jjuneau1/MiniFAST/README.md

# MiniFAST
MiniFAST: Fast and Sensitive Miniaturized microscope for neural recording - compatible with Miniscope.org
