jjuneau1/MiniFAST/MiniFAST PCB/BOM/MiniPCBR3-for-assembly.xls

This is a sample BOM for Sierra Circuits' online BOM pricing system. Please use this preferred format for your BOM that you upload.
Note: DNI applies to whole row. If only some specific locations of a given ITEM are not to be installed, please create two rows for that item and mark one as DNI.
BOM: <MiniPCB>
R3
Jill Juneau/Rice University
Item # | Quantity per board | Manufacturer Part # | Do Not Install | Reference designators | Vendor (optional) | Vendor Part Number (optional) | Value (optional) | Size / Footprint (optional) | Part description/ specs (optional, but recommended) | Manfacturer (optional)
1 | 9 | C1005X8R1E103M050BA |  | C5, C21, C23, C25, C28, C31, C52, C53, C58 | Digi-Key | 445-13941-1-ND | 0.01uF | C0402 | CAP CER 10000PF 25V X7R 0402 | TDK
2 | 1 | GCM155R71E473KA55D |  | C34 | Digi-Key | 490-4760-1-ND | 0.047uF | C0402 | CAP CER 0.047UF 25V X7R 0402 | Murata
3 | 20 | GMK105BJ104KV-F |  | C2, C20, C22, C24, C27, C30, C33, C36, C38, C47, C48, C49, C50, C51, C54, C55, C56, C57, C60, C62 | Digi-Key | 587-1994-1-ND | 0.1uF | C0402 | CAP CER 0.1UF 35V X5R 0402 | TDK
4 | 1 | GRM155C8YA224ME01D |  | C4 | Digi-Key | 490-10446-1-ND | 0.22uF | C0402 | CAP CER 0.22UF 35V X6S 0402 | TDK
5 | 10 | CGB2A1X5R1E105M033BC |  | C1, C3, C11, C13, C14, C19, C35, C44, C45, C46 | Digi-Key | 445-13186-1-ND | 1uF | C0402 | MLCC, SOFT TERMINATION, 0402, X5, 35V | TDK
6 | 8 | GRM153R60J475ME15D |  | C15, C16, C17, C18, C37, C39, C41, C42 | Digi-Key | 490-13232-2-ND | 4.7uF | C0402 | CAP CER 4.7UF 6.3V X5R 0402 | Murata
7 | 2 | C1608JB1E475M080AC |  | C59, C61 | Digi-Key | 445-11254-1-ND | 4.7uF | C0603 | CAP CER 4.7UF 25V JB 0603 | TDK
8 | 8 | GRM155R60J106ME47D |  | C6, C7, C8, C9, C10, C12, C26, C29 | Digi-Key | 490-13239-1-ND | 10uF | C0402 | CAP CER 10UF 6.3V X5R 0402 | Murata
9 | 1 | GRM155R60J156ME05D |  | C32 | Mouser | 490-18659-1-ND | 15uF | C0402 | CAP CER 15UF 6.3V X5R 0402 | TDK
10 | 1 | LTST-C191KRKT |  | D1 | Digi-Key | 160-1447-1-ND |  | D0603 | LED
11 | 2 | MMZ1005Y102CT000 |  | L1, L2 | Digi-Key | 445-2157-1-ND |  | L0402 | FERRITE BEAD 1 KOHM 0402 1LN | TDK
12 | 1 | BRC2012T4R7MD |  | L3 | Digi-Key/ Customer Provided | 587-2907-1-ND |  | 2012 | FIXED IND 4.7UH 600MA 344.5 MOHM | Samsung Electro-Mechanics
13 | 1 | LPS4018-104MRC |  | L4 | Mouser | 994-LPS4018-104MRC | 100uH | LPS4018 | Fixed Inductors LPS4018 Low Profile 100uH 0.5A 20% SMD | Coilcraft
14 | 1 | BLM18KG601SN1D |  | L5 | Digi-Key | 490-5258-1-ND |  | L0603 | 600 OHM 0603 1LN | Murata
15 | 1 | ERJ-2RKF10R0X |  | R12 | Digi-Key | P10.0LCT-ND | 10 | R0402 | Resistor | Panasonic
16 | 1 | ERJ-2RKF49R9X |  | R2 | Digi-Key | P49.9LTR-ND | 49.9 | R0402 | Resistor | Panasonic
17 | 6 | ERJ-2RKF4990X |  | R14, R15, R16, R17, R18, R19 | Digi-Key | P499LCT-ND | 499 | R0402 | RES SMD 499 OHM 1% 1/10W 0402 | Panasonic
18 | 4 | ERJ-2RKF1001X |  | R6, R7, R11, R13 | Digi-Key | P1.00KLCT-ND | 1k | R0402 | RES SMD 1K OHM 1% 1/10W 0402 | Panasonic
19 | 1 | ERJ-2RKF4021X |  | R10 | Digi-Key | P4.02KLCT-ND | 4.02K | R0402 | RES SMD 4.02K OHM 1% 1/10W 0402 | Panasonic
20 | 1 | ERJ-2RKF1002X |  | R4 | Digi-Key | P10.0KLCT-ND | 10k | R0402 | RES SMD 10K OHM 1% 1/10W 0402 | Panasonic
21 | 3 | ERJ-2RKF1003X |  | R1, R3, R5 | Digi-Key | P100KLCT-ND | 100k | R0402 | RES SMD 100K OHM 1% 1/10W 0402 | Panasonic
22 | 1 | ERJ-2GE0R00X |  | R9 | Digi-Key | P0.0JCT-ND | 0 | R0403 | RES SMD 0 OHM JUMPER 1/10W 0402 | Panasonic
23 | 1 | Do Not Populate |  | R8 |  |  | DNP
24 | 1 | IMX290LLR-C |  | U1 | Customer Provided |  |  | 110-LGA - Thin | Sony Image Sensor | Sony
25 | 1 | DSC1001DL2-074.2500 |  | U2 | Digi-Key | DSC1001DL2-074.2500-ND |  | CDFN | 74.25MHz Oscillator | Microchip
26 | 1 | DS90UB913ATRTVRQ1 |  | U3 | Digi-Key | 296-46295-1-ND |  | WQFN32 for DS90UB913A | DS90UR913ASERIALIZER | TI
27 | 1 | MAX14595ETA+T |  | U4 | Digi-Key | MAX14595ETA+TCT-ND |  | 8 TDFN | Level Translator | Maxim
28 | 1 | DAC5571IDBVR |  | U5 | Digi-Key | 296-38918-1-ND |  | TI-DBV6_M | Low-Power, 8-Bit DAC with High-Speed I2C Input, -40 to 105 degC, 6-pin SOT23 (DBV6), Green (RoHS & no Sb/Br) | TI
29 | 1 | LT3092EDD#TRPBF |  | U6 | Digi-Key | LT3092EDD#TRPBFCT-ND |  | LT-DD-8_V | 200 mA Two-Terminal Programmable Current Source, 0.3 mA Isupply, 8-pin SON (DD-8), -40 to 125 degC, Pb-Free | LT
30 | 1 | TLV71128512DSET |  | U7 | Digi-Key | 296-47460-2-ND |  | DSE | Dual 2.85V and 1.2V Linear Regulator | TI
31 | 1 | TPS72718DSER |  | U8 | Mouser | 595-TPS72718DSER |  | DSE | Single 1.8V Linear Regulator | TI
END OF BOM
