jjuneau1/MiniFAST/MiniFAST PCB/Project Outputs for MiniR3/MiniPCBR3.xlsx

Comment | Description | Designator | Footprint | LibRef | Quantity
1uF |  | C1, C3, C11, C13, C14, C19, C35, C44, C45, C46 | SMD CAP 0402 | Capacitor | 10
0.1uF |  | C2, C20, C22, C24, C27, C30, C33, C36, C38, C47, C48, C49, C50, C51, C54, C55, C56, C57, C60, C62 | SMD CAP 0402 | Capacitor | 20
0.22uF |  | C4 | SMD CAP 0402 | Capacitor | 1
0.01uF |  | C5, C21, C23, C25, C28, C31, C52, C53, C58 | SMD CAP 0402 | Capacitor | 9
10uF |  | C6, C7, C8, C9, C10, C12, C26, C29 | SMD CAP 0402 | Capacitor | 8
4.7uF |  | C15, C16, C17, C18, C37, C39, C41, C42 | SMD CAP 0402 | Capacitor | 8
15uF |  | C32 | SMD CAP 0402 | Capacitor | 1
0.047uF |  | C34 | SMD CAP 0402 | Capacitor | 1
4.7uF |  | C59, C61 | SMD Capacitor 0603 | Capacitor | 2
LED 0603 | LTST_C195TBJRKT | D1 | LED_0603 | LED 0603 | 1
Coax Connector |  | J1, J2 | Coax Direct Solder ThroughHoles | Coax Connector | 2
Ferrite Bead |  | L1, L2 | Ferrite Bead 402 | Ferrite Bead | 2
4.7uH | 4.7uH | L3 | CIG21L4R7MNE | Ferrite Bead | 1
LPS4018-104MR | Coilcraft Inductor | L4 | LPS4018-104MR | LPS4018-104MR | 1
Ferrite Bead |  | L5 | BLM18KG601SN1D | Ferrite Bead | 1
100K |  | R1, R3, R5 | SMD RES 0402 | Resistor | 3
49.9 |  | R2 | SMD RES 0402 | Resistor | 1
10k |  | R4 | SMD RES 0402 | Resistor | 1
1k |  | R6, R7, R11, R13 | SMD RES 0402 | Resistor | 4
1 |  | R8, R9 | SMD RES 0402 | Resistor | 2
4.02K |  | R10 | SMD RES 0402 | Resistor | 1
10 |  | R12 | SMD RES 0402 | Resistor | 1
499 |  | R14, R15, R16, R17, R18, R19 | SMD RES 0402 | Resistor | 6
SonyIMX290LLR-C | Sony Image Sensor | U1 | 110-LGA - Thin | IMX290LLR-C | 1
DSC1001DI1-074.2500 | 74.25MHz Oscillator | U2 | CDFN | Microchip Oscillator | 1
DS90UR913A | DS90UR913ASERIALIZER | U3 | WQFN32 for DS90UB913A | DS90UR913A | 1
MAX14595ETA+T | Level Translator | U4 | 8 TDFN | MAX14595ETA+T | 1
DAC5571IDBVR | DAC5571IDBVR | U5 | DBV | DAC5571 | 1
LT3092EDD#PBF | 200 mA Two-Terminal Programmable Current Source, 0.3 mA Isupply, 8-pin SON (DD-8), -40 to 125 degC, Pb-Free | U6 | LT-DD-8_V | LT3092EDD#PBF | 1
TLV71128512DSET | Dual 2.85V and 1.2V Linear Regulator | U7 | DSE | TLV71128512DSET | 1
TPS72718DSER | Single 1.8V Linear Regulator | U8 | DSE | TPS72718DSER | 1
