jjuneau1/MiniFAST/3D Print MiniFAST Housing/STL Files (printing)/Main_RNEL.stl

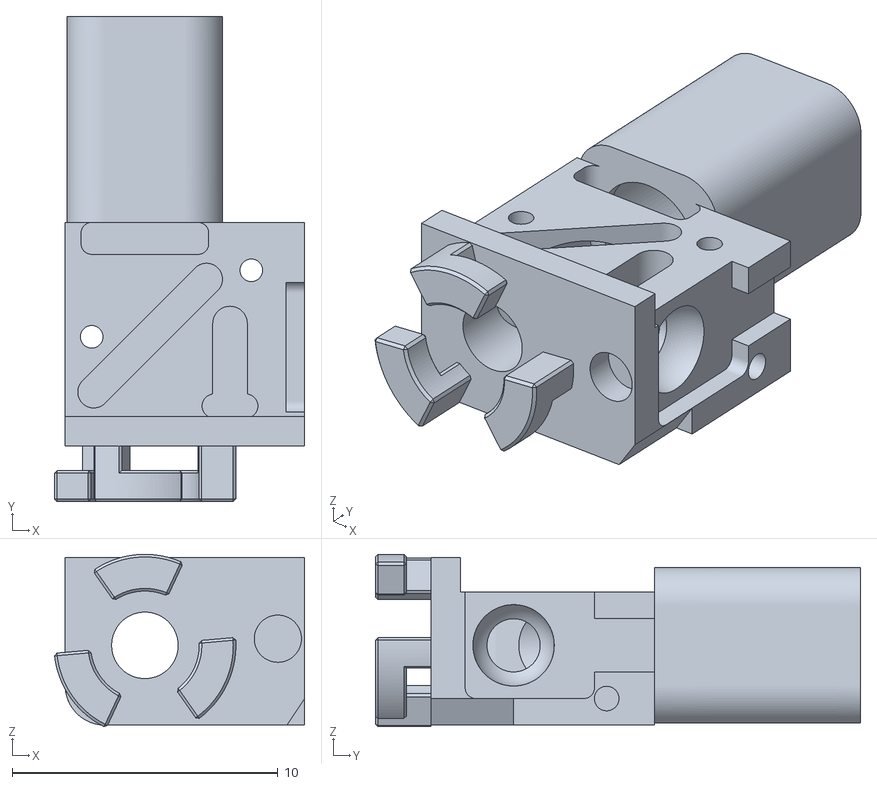
[picture p1: CAD file, 2020-07-23]
3D Print MiniFAST Housing/STL Files (printing)/Main_RNEL.stl
9.40 x 18.2 x 6.48
