jjuneau1/MiniFAST/3D Print Lens Holder_Slide Holder_PatchClampHolder/STEP files/Clamp Miniscope.step

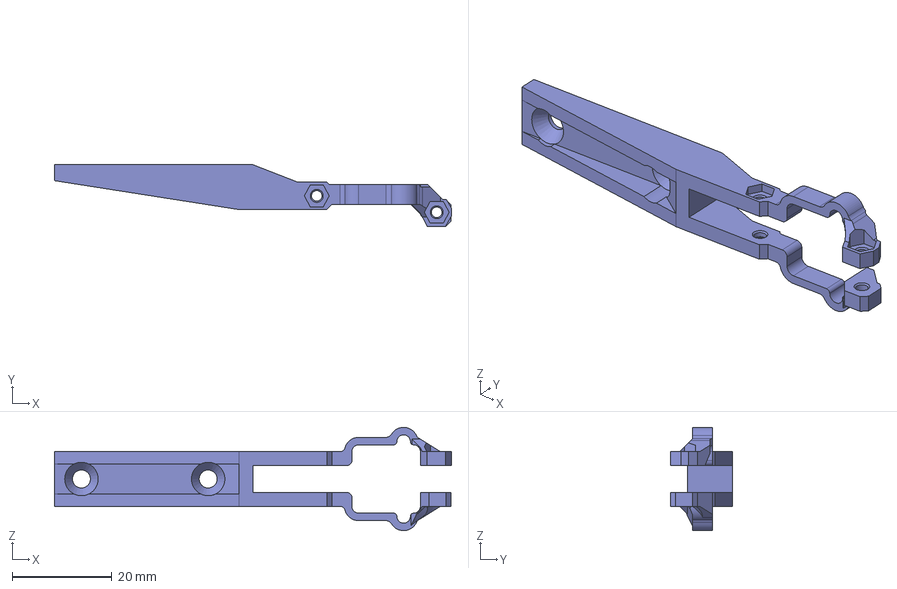
[picture p2: CAD file, 2020-07-23]
3D Print Lens Holder_Slide Holder_PatchClampHolder/STEP files/Clamp Miniscope.step
79.6 x 12.4 x 20.7 mm
