jjuneau1/MiniFAST/3D Print MiniFAST Housing/STEP Files (editting)/Cover_RNEL.step

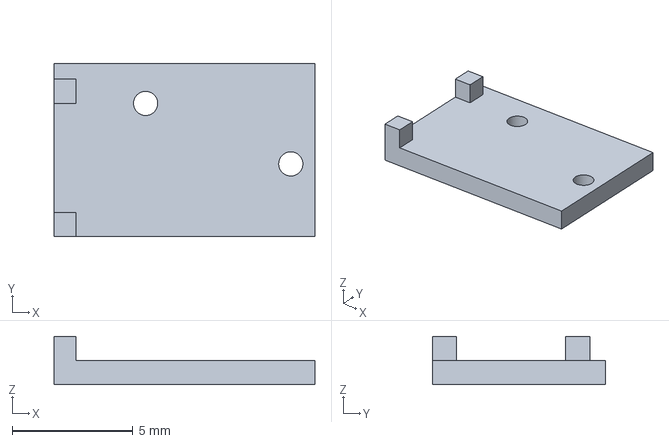
[picture p3: CAD file, 2020-07-23]
3D Print MiniFAST Housing/STEP Files (editting)/Cover_RNEL.step
10.8 x 7.15 x 2.00 mm
