jjuneau1/MiniFAST/3D Print Lens Holder_Slide Holder_PatchClampHolder/STEP files/Slide Holder.step

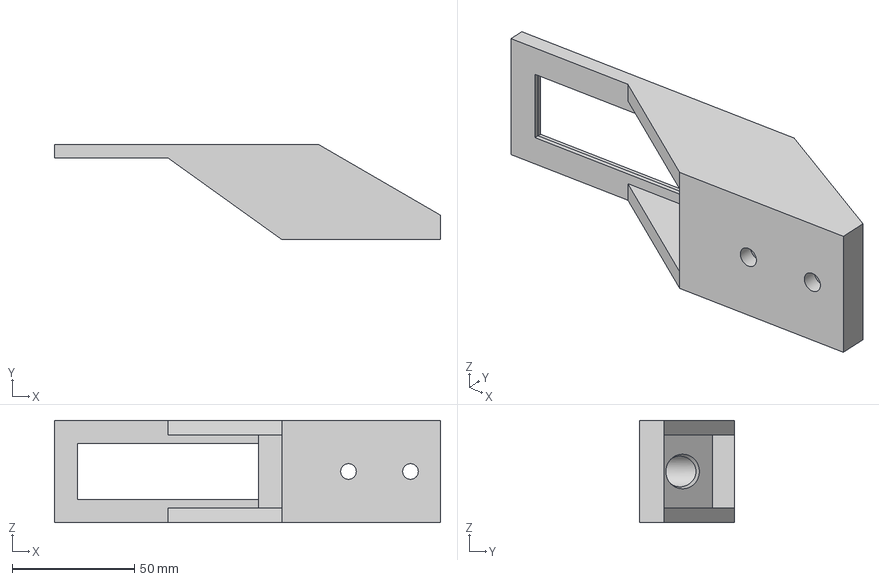
[picture p4: CAD file, 2020-07-23]
3D Print Lens Holder_Slide Holder_PatchClampHolder/STEP files/Slide Holder.step
158.2 x 39.0 x 41.9 mm
