jjuneau1/MiniFAST/3D Print MiniFAST Housing/STEP Files (editting)/Top_V2_RNEL.step

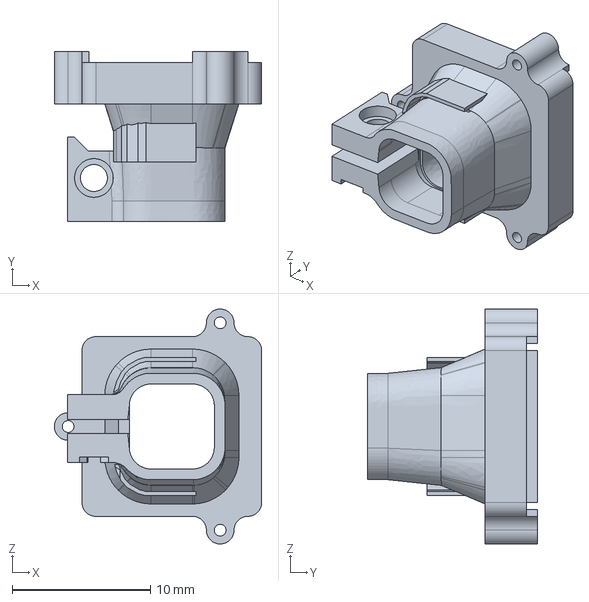
[picture p5: CAD file, 2020-07-23]
3D Print MiniFAST Housing/STEP Files (editting)/Top_V2_RNEL.step
15.0 x 12.3 x 17.0 mm
