jjuneau1/MiniFAST/3D Print Lens Holder_Slide Holder_PatchClampHolder/STEP files/Lens Holder.step

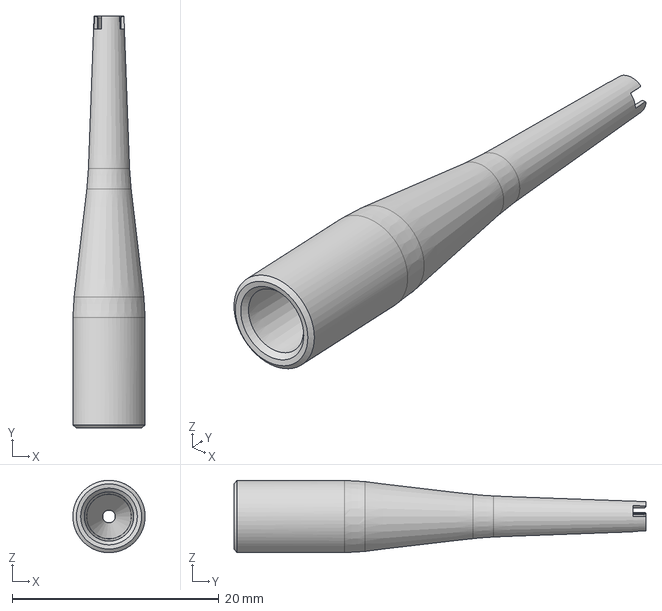
[picture p6: CAD file, 2020-07-23]
3D Print Lens Holder_Slide Holder_PatchClampHolder/STEP files/Lens Holder.step
7.00 x 39.9 x 7.00 mm
