jjuneau1/MiniFAST/3D Print MiniFAST Housing/STEP Files (editting)/Cap_Closer_RNEL.step

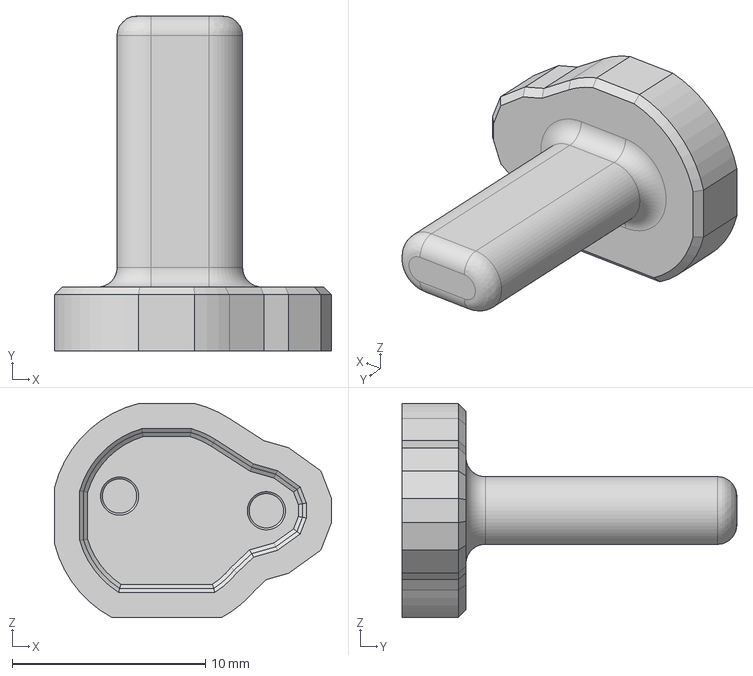
[picture p7: CAD file, 2020-07-23]
3D Print MiniFAST Housing/STEP Files (editting)/Cap_Closer_RNEL.step
14.3 x 17.3 x 11.1 mm
