jjuneau1/MiniFAST/3D Print MiniFAST Housing/STL Files (printing)/Base_RNEL.stl

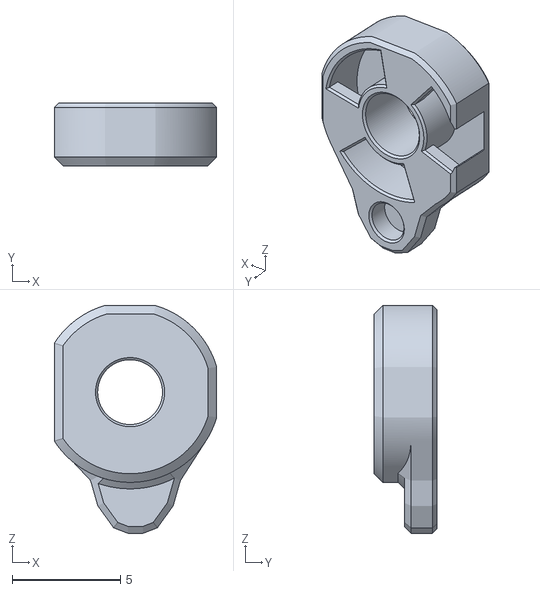
[picture p8: CAD file, 2020-07-23]
3D Print MiniFAST Housing/STL Files (printing)/Base_RNEL.stl
7.50 x 2.90 x 10.5
