jjuneau1/MiniFAST/3D Print Lens Holder_Slide Holder_PatchClampHolder/STEP files/Clamp Reversed.step

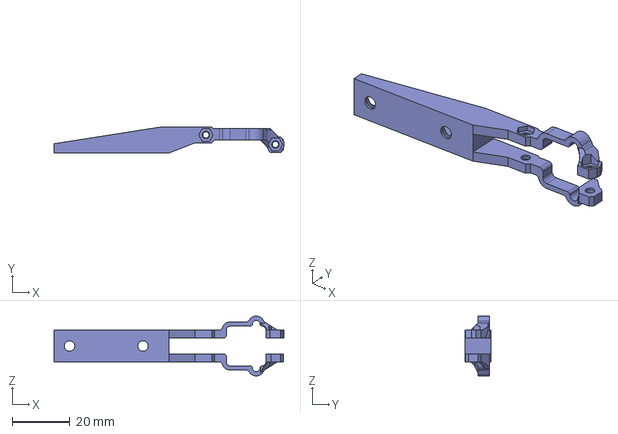
[picture p9: CAD file, 2020-07-23]
3D Print Lens Holder_Slide Holder_PatchClampHolder/STEP files/Clamp Reversed.step
79.6 x 9.00 x 20.7 mm
