jjuneau1/MiniFAST/3D Print Lens Holder_Slide Holder_PatchClampHolder/STEP files/Patch Clamping Clamp.step

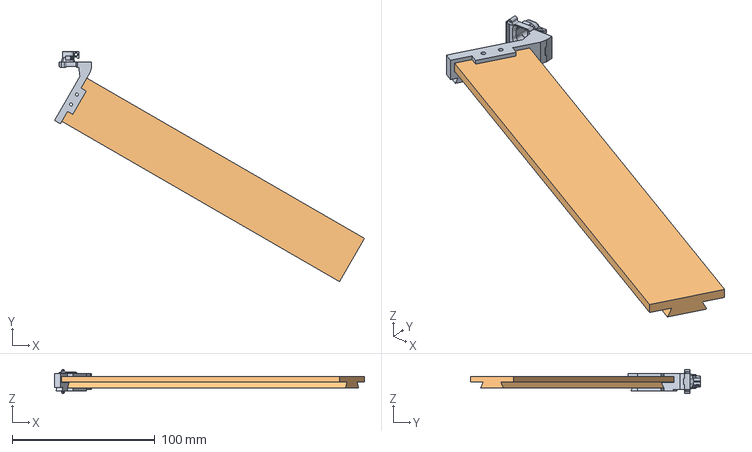
[picture p10: CAD file, 2020-07-23]
3D Print Lens Holder_Slide Holder_PatchClampHolder/STEP files/Patch Clamping Clamp.step
217.3 x 161.5 x 17.0 mm
