jjuneau1/MiniFAST/3D Print MiniFAST Housing/STEP Files (editting)/Cap_RNEL.step

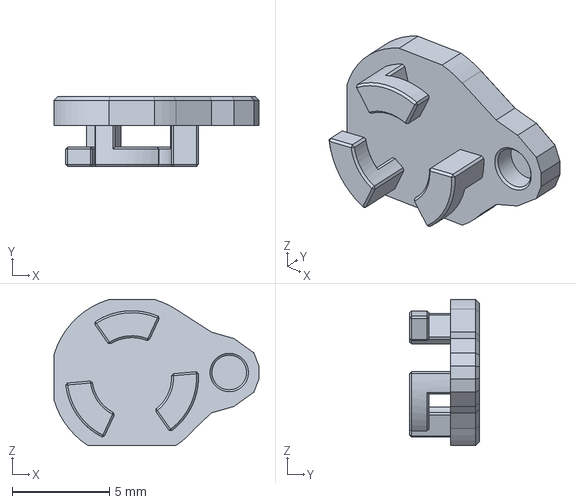
[picture p11: CAD file, 2020-07-23]
3D Print MiniFAST Housing/STEP Files (editting)/Cap_RNEL.step
10.5 x 3.60 x 7.50 mm
