jjuneau1/MiniFAST/(list of files, cad)

Other CAD files:
3D Print MiniFAST Housing/STEP Files (editting)/Main_RNEL.step
3D Print MiniFAST Housing/STL Files (printing)/Cover_RNEL.stl
3D Print Lens Holder_Slide Holder_PatchClampHolder/STEP files/Histology Slide Mount.step
3D Print MiniFAST Housing/STEP Files (editting)/Base_RNEL.step
3D Print MiniFAST Housing/STL Files (printing)/Top_V2_RNEL.stl
3D Print MiniFAST Housing/STL Files (printing)/Cap_Closer_RNEL.stl
3D Print MiniFAST Housing/STL Files (printing)/Cap_RNEL.stl
3D Print Lens Holder_Slide Holder_PatchClampHolder/STL files/Clamp Miniscope.stl
3D Print Lens Holder_Slide Holder_PatchClampHolder/STL files/Clamp Reversed.stl
3D Print Lens Holder_Slide Holder_PatchClampHolder/STL files/Histology Slide Mount.stl
3D Print Lens Holder_Slide Holder_PatchClampHolder/STL files/Lens Holder.stl
3D Print MiniFAST Housing/STEP Files (editting)/Top_V1_RNEL.step
3D Print MiniFAST Housing/STL Files (printing)/Top_V1_RNEL.stl
