jjuneau1/MiniFAST/3D Print MiniFAST Housing/Fancy Images/RNEL Attachment.png

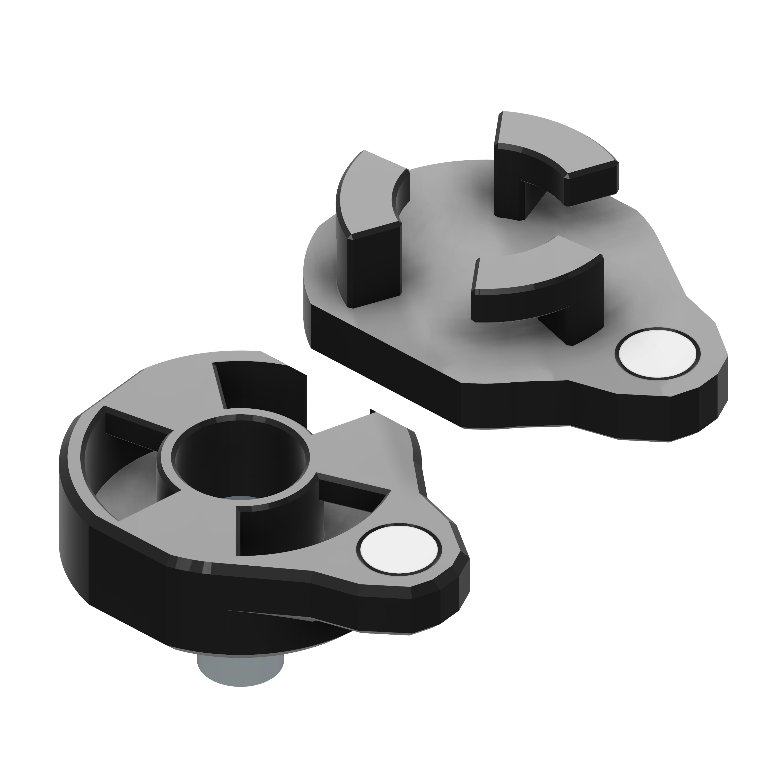
3D Print MiniFAST Housing/Fancy Images/RNEL Attachment.png
