jjuneau1/MiniFAST/3D Print MiniFAST Housing/Fancy Images/RNEL Miniscope.png

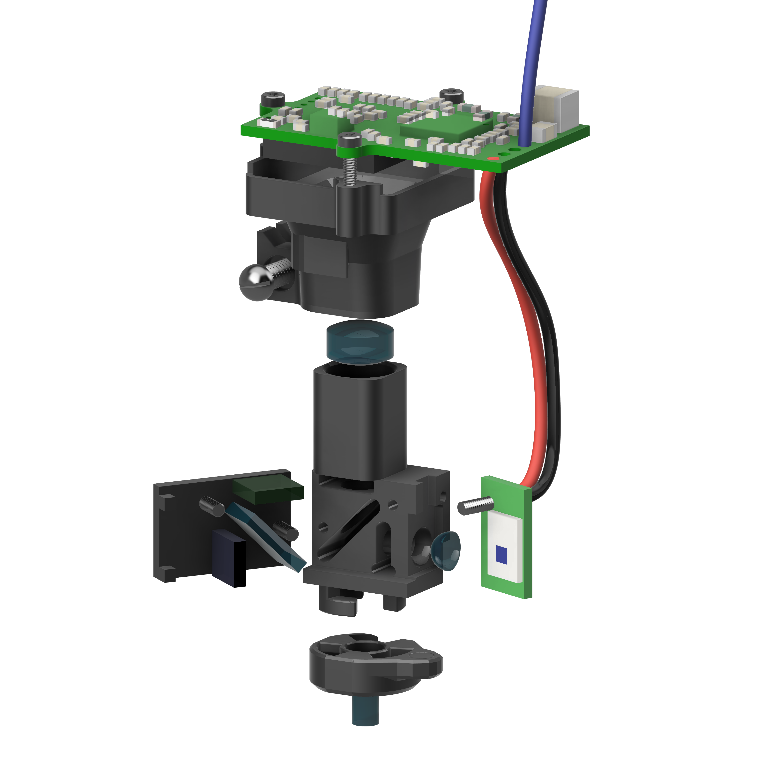
3D Print MiniFAST Housing/Fancy Images/RNEL Miniscope.png
