jjuneau1/MiniFAST/3D Print MiniFAST Housing/magnet orientations.png

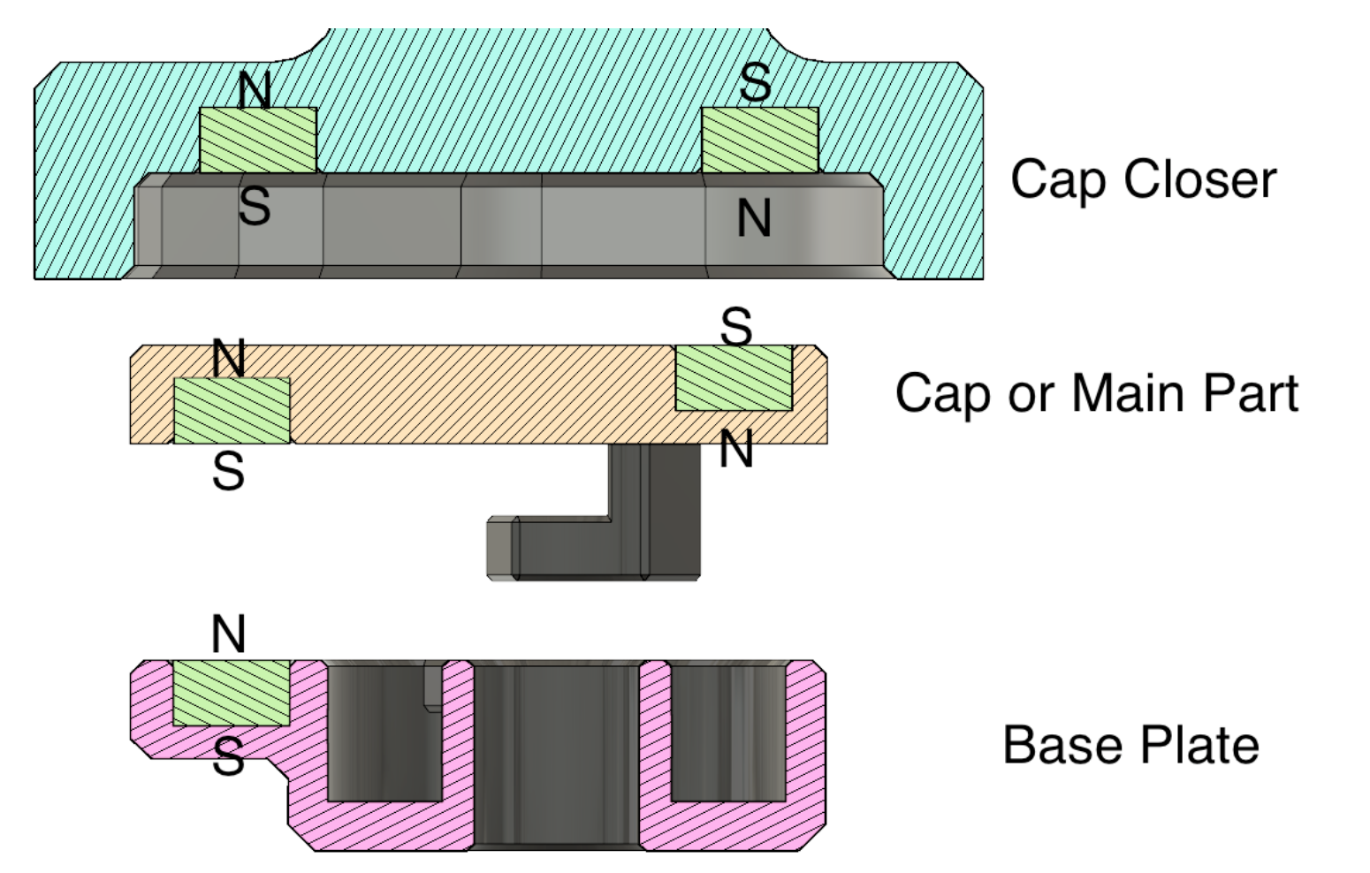
3D Print MiniFAST Housing/magnet orientations.png
