jjuneau1/MiniFAST/3D Print MiniFAST Housing/Miniscope 12-19/assembled#1.png

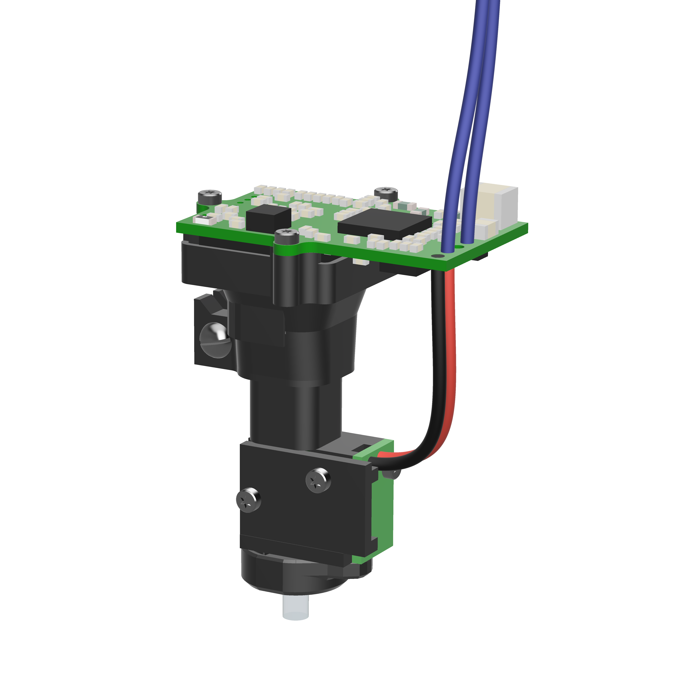
3D Print MiniFAST Housing/Miniscope 12-19/assembled#1.png
