jjuneau1/MiniFAST/MiniFAST PCB/MiniR3.pdf

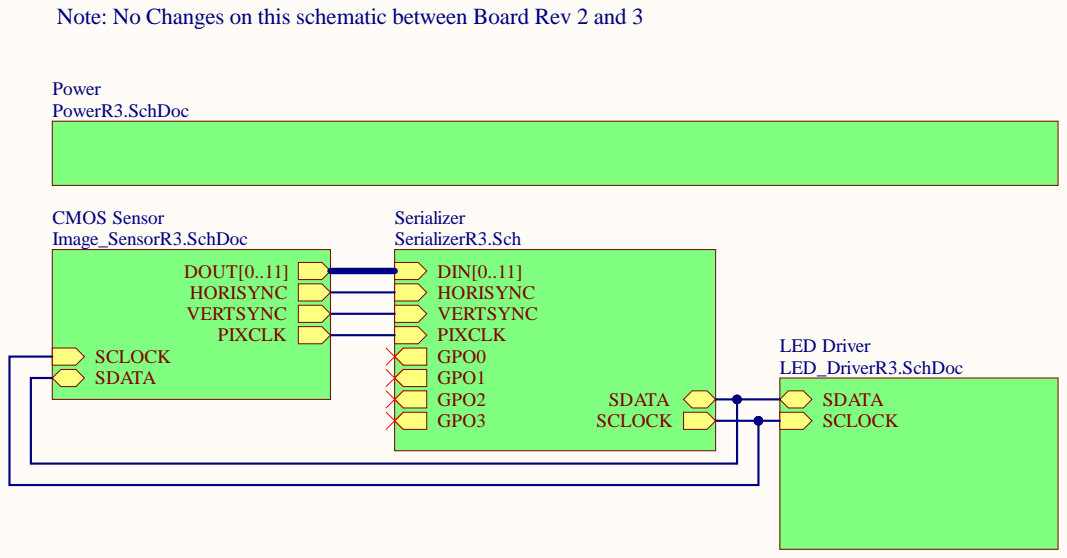
[picture p17: page 1]

Note: No Changes on this schematic between Board Rev 2 and 3

Parent Sheet Block Diagram
Title

Date:
C:\Kemere Lab\GitHub Files\MiniFAST PCB\Serializer_SystemR3.SchDoc
Revision History Updated from v3.2 Miniscope.org

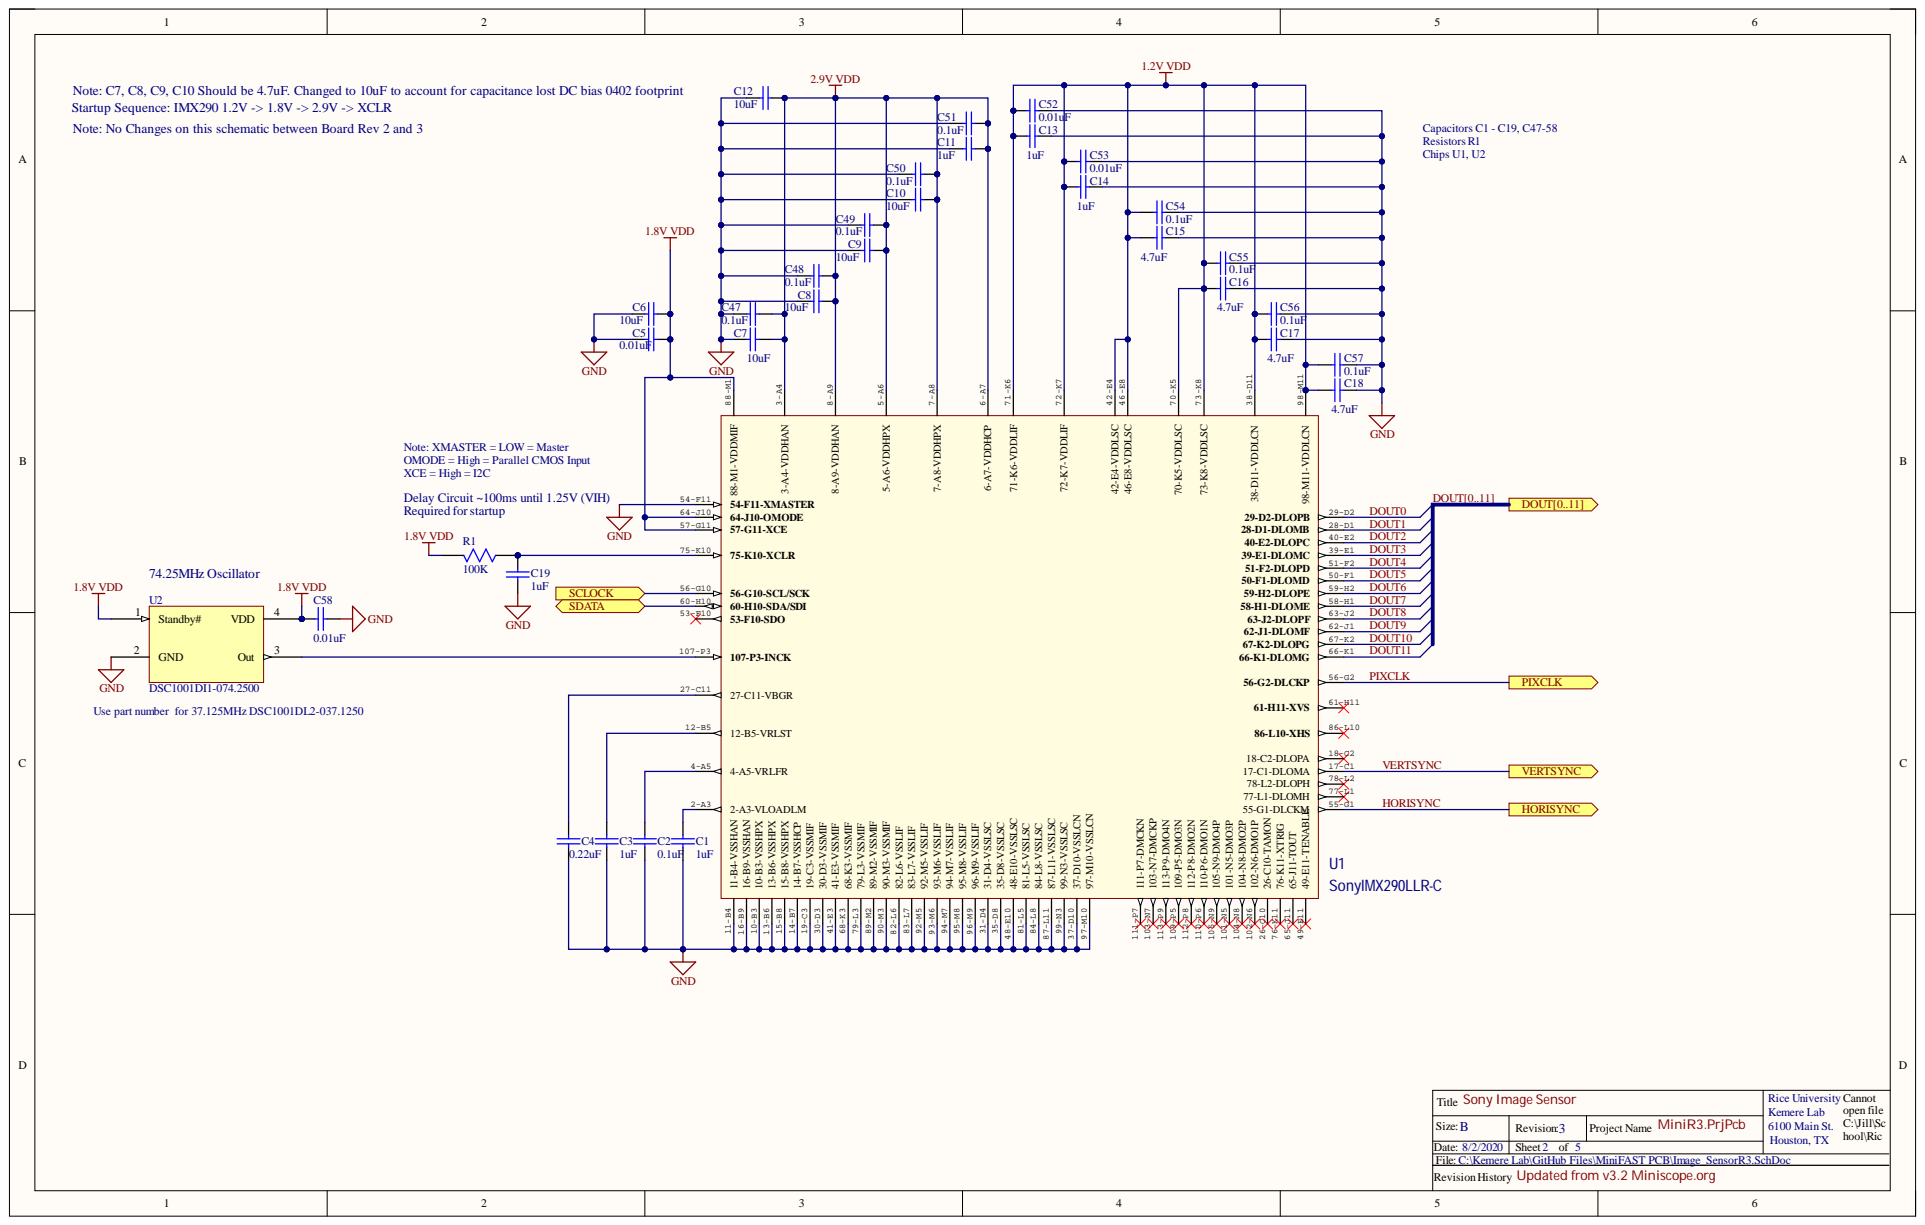
[picture p18: page 2]

Note: C7, C8, C9, C10 Should be 4.7uF. Changed to 10uF to account for capacitance lost DC bias 0402 footprint
Startup Sequence: IMX290 1.2V -> 1.8V -> 2.9V -> XCLR
Note: No Changes on this schematic between Board Rev 2 and 3

Note: XMASTER = LOW = Master
OMODE = High = Parallel CMOS Input
XCE = High = I2C

Delay Circuit ~100ms until 1.25V (VIH)
Required forstartup

27-C11-VBGR 27-C11

Use part number for 37.125MHz DSC1001DL2-037.1250

4-A5-VRLFR 4-A5

2-A3-VLOADLM 2-A3 | HORISYNC

Sony Image Sensor Title | Rice University Cannot Kemere Lab open file 6100 Main St. C:\Jill\Sc Houston, TX hool\Ric

Size: B | Revision: 3 | MiniR3.PrjPcb Project Name

Date: 8/2/2020 | Sheet 2 of 5

C:\Kemere Lab\GitHub Files\MiniFAST PCB\Image_SensorR3.SchDoc
RevisionHistory Updated from v3.2 Miniscope.org

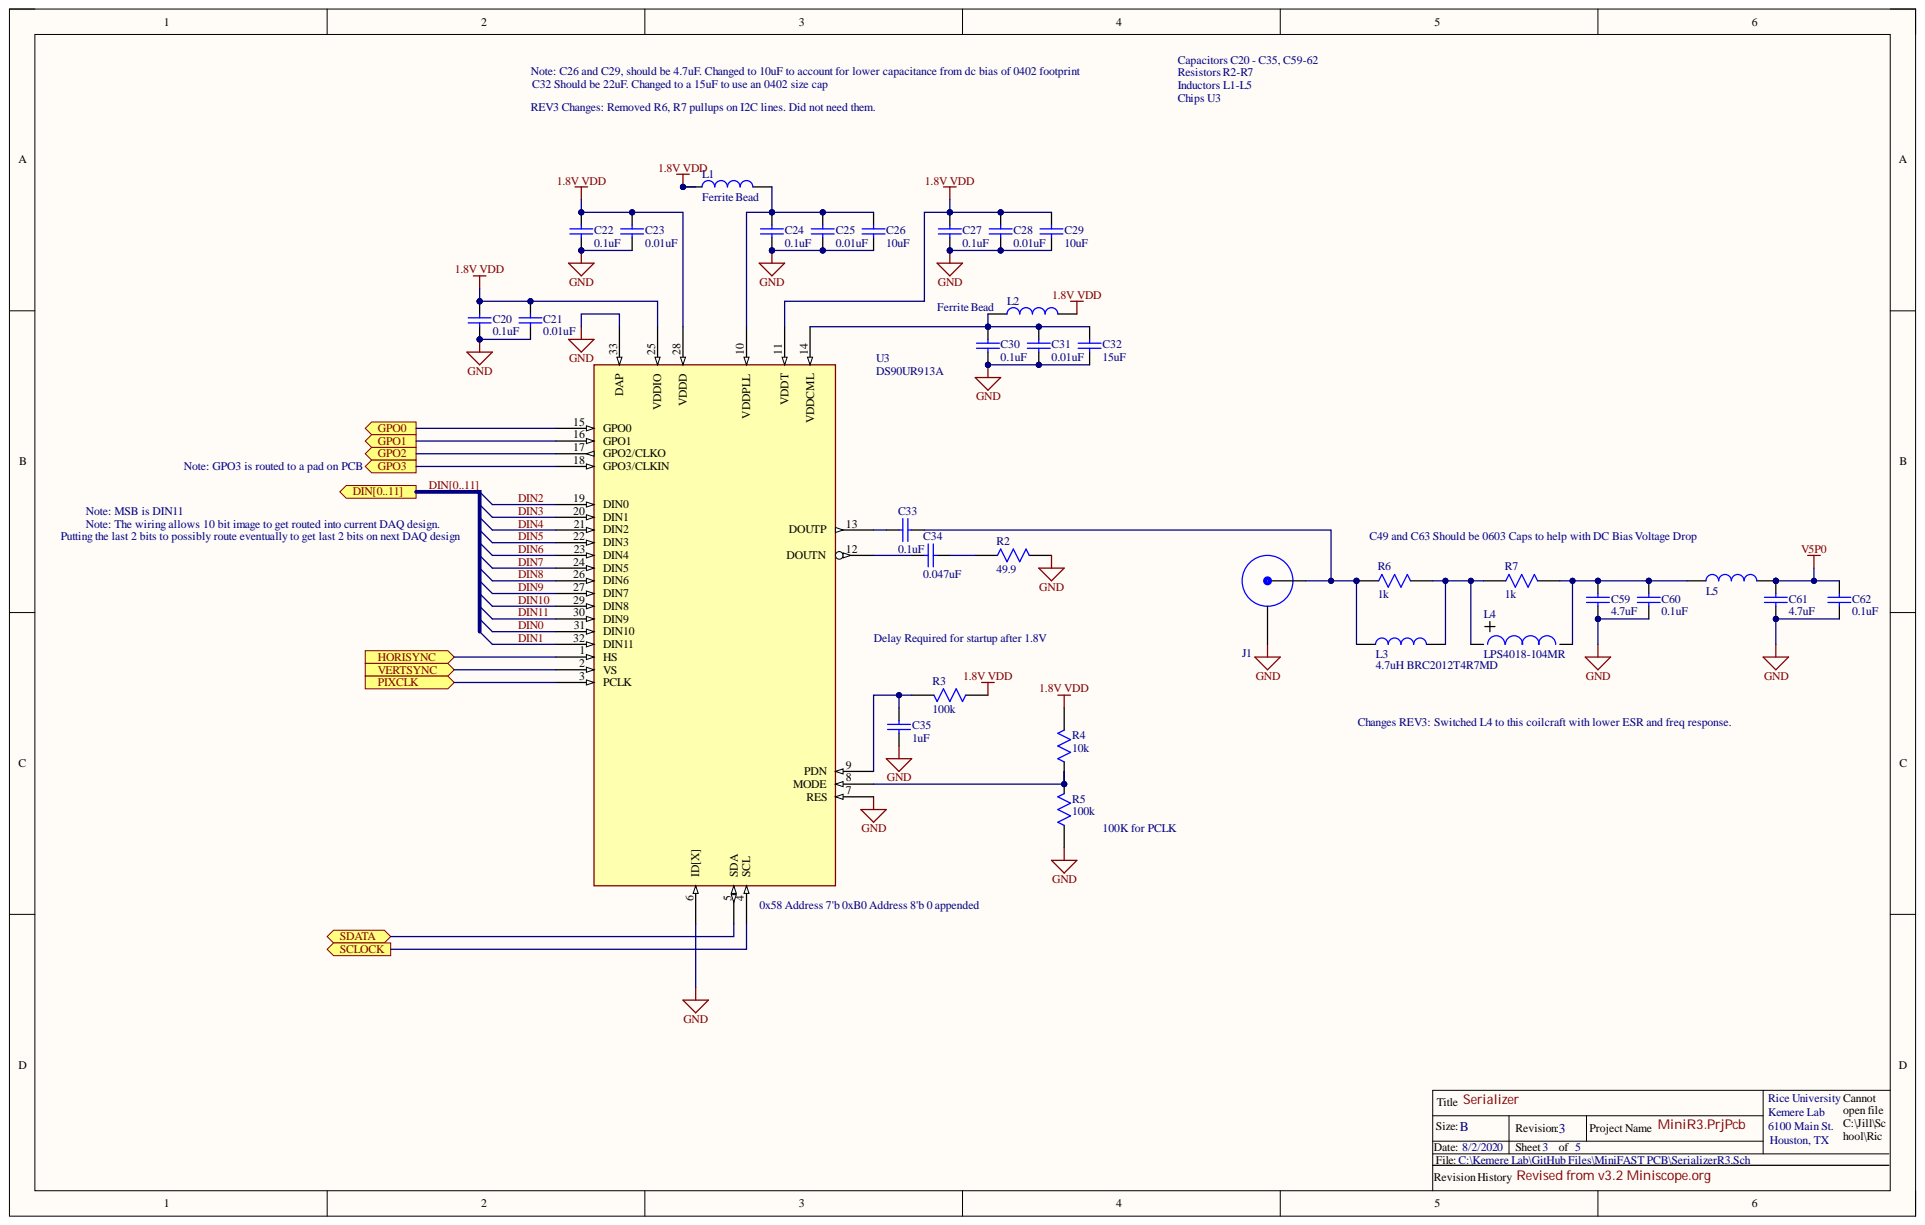
[picture p19: page 3]

Note: C26 and C29, should be 4.7uF. Changed to 10uF to account for lower capacitance from dc bias of 0402 footprint
C32 Should be 22uF. Changed to a 15uF to use an 0402 size cap

REV3 Changes: Removed R6, R7 pullups on I2C lines. Did not need them.

Note: GPO3 is routed to a pad on PCB

Note: MSB is DIN11
Note: The wiring allows 10 bit image to get routed into current DAQ design.
Putting the last 2 bits to possibly route eventually to get last 2 bits on next DAQ design

C49 and C63 Should be 0603 Caps to help with DC Bias Voltage Drop

Delay Required for startup after 1.8V

Changes REV3: Switched L4 to this coilcraft with lower ESR and freq response.

Serializer Title | Rice University Cannot Kemere Lab open file 6100 Main St. C:\Jill\Sc Houston, TX hool\Ric

Size: B | Revision: 3 | MiniR3.PrjPcb Project Name

Date: 8/2/2020 | Sheet 3 of 5

C:\Kemere Lab\GitHub Files\MiniFAST PCB\SerializerR3.Sch
RevisionHistory Revised from v3.2 Miniscope.org

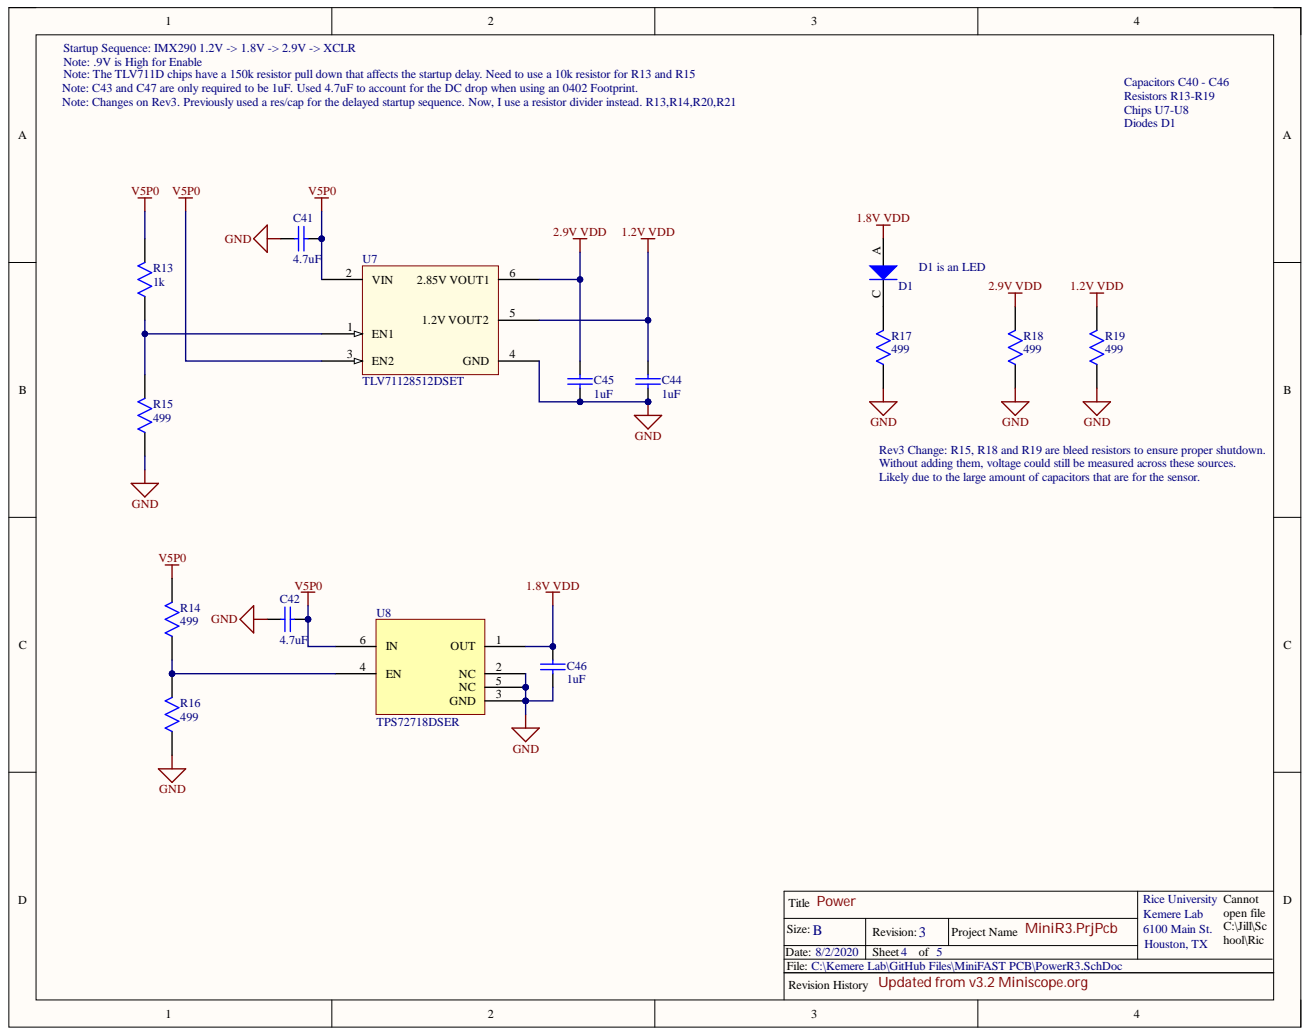
[picture p20: page 4]

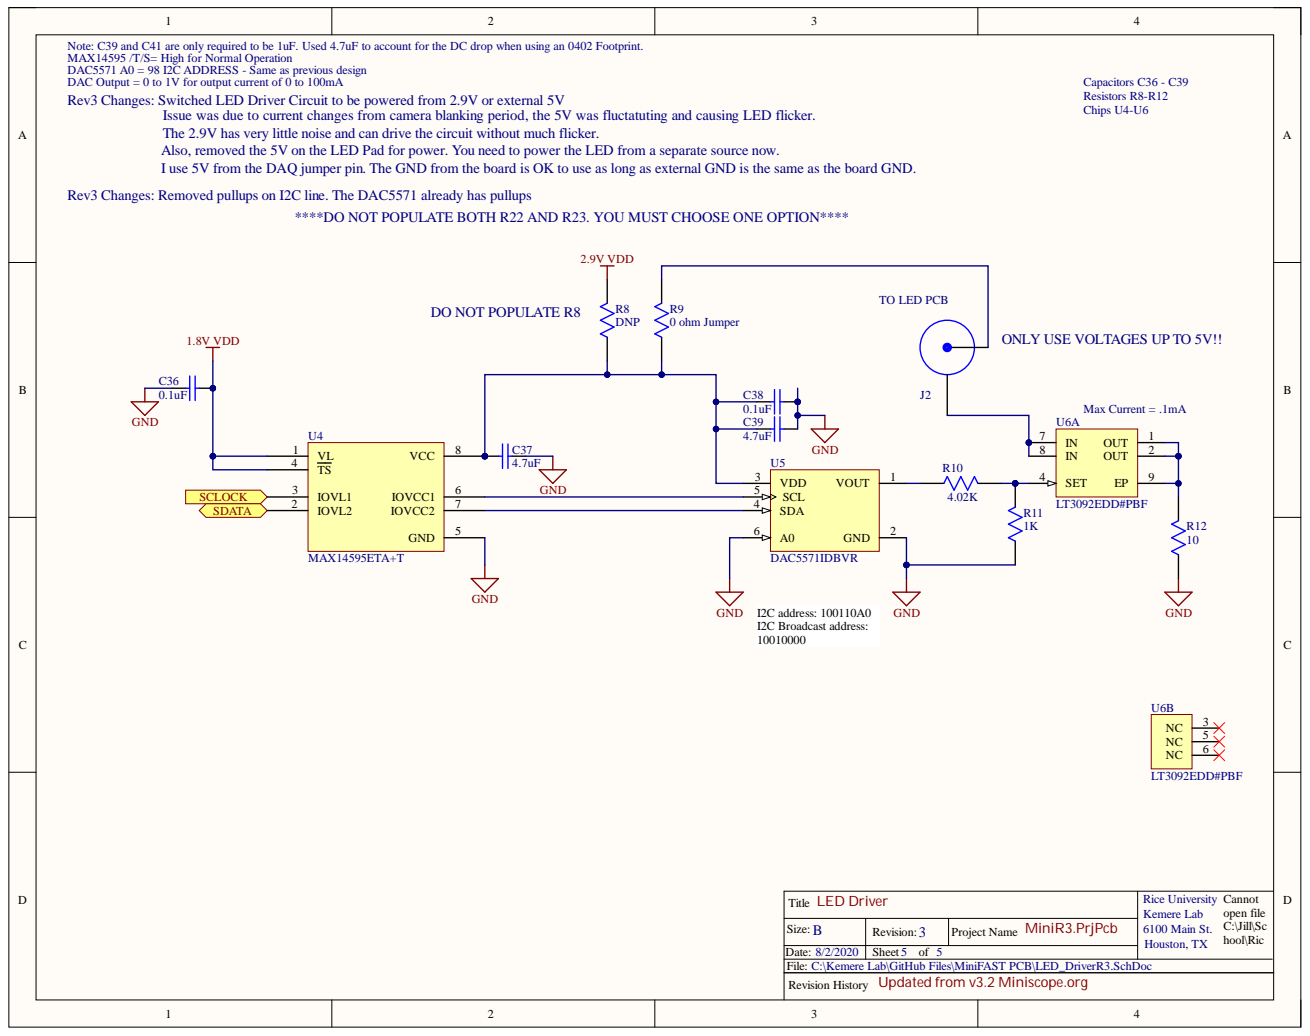
[picture p21: page 5]

Note: C39 and C41 are only required to be 1uF. Used 4.7uF to account for the DC drop when using an 0402 Footprint. MAX14595 /T/S= High for Normal Operation

DAC5571 A0 = 98 I2C ADDRESS - Same as previous design
DAC Output = 0 to 1V for output current of 0 to 100mA
Rev3 Changes: Switched LED Driver Circuit to be powered from 2.9V or external 5V

Issue was due to current changes from camera blanking period, the 5V was fluctatuting and causing LED flicker.
The 2.9V has very little noise and can drive the circuit without much flicker.
Also, removed the 5V on the LED Pad for power. You need to power the LED from a separate source now.
I use 5V from the DAQ jumper pin. The GND from the board is OK to use as long as external GND is the same as the board GND.

Rev3 Changes: Removed pullups on I2C line. The DAC5571 already has pullups

****DO NOT POPULATE BOTH R22 AND R23. YOU MUST CHOOSE ONE OPTION****

ONLY USE VOLTAGES UP TO 5V!!

Date:
C:\Kemere Lab\GitHub Files\MiniFAST PCB\LED_DriverR3.SchDoc
Revision History Updated from v3.2 Miniscope.org

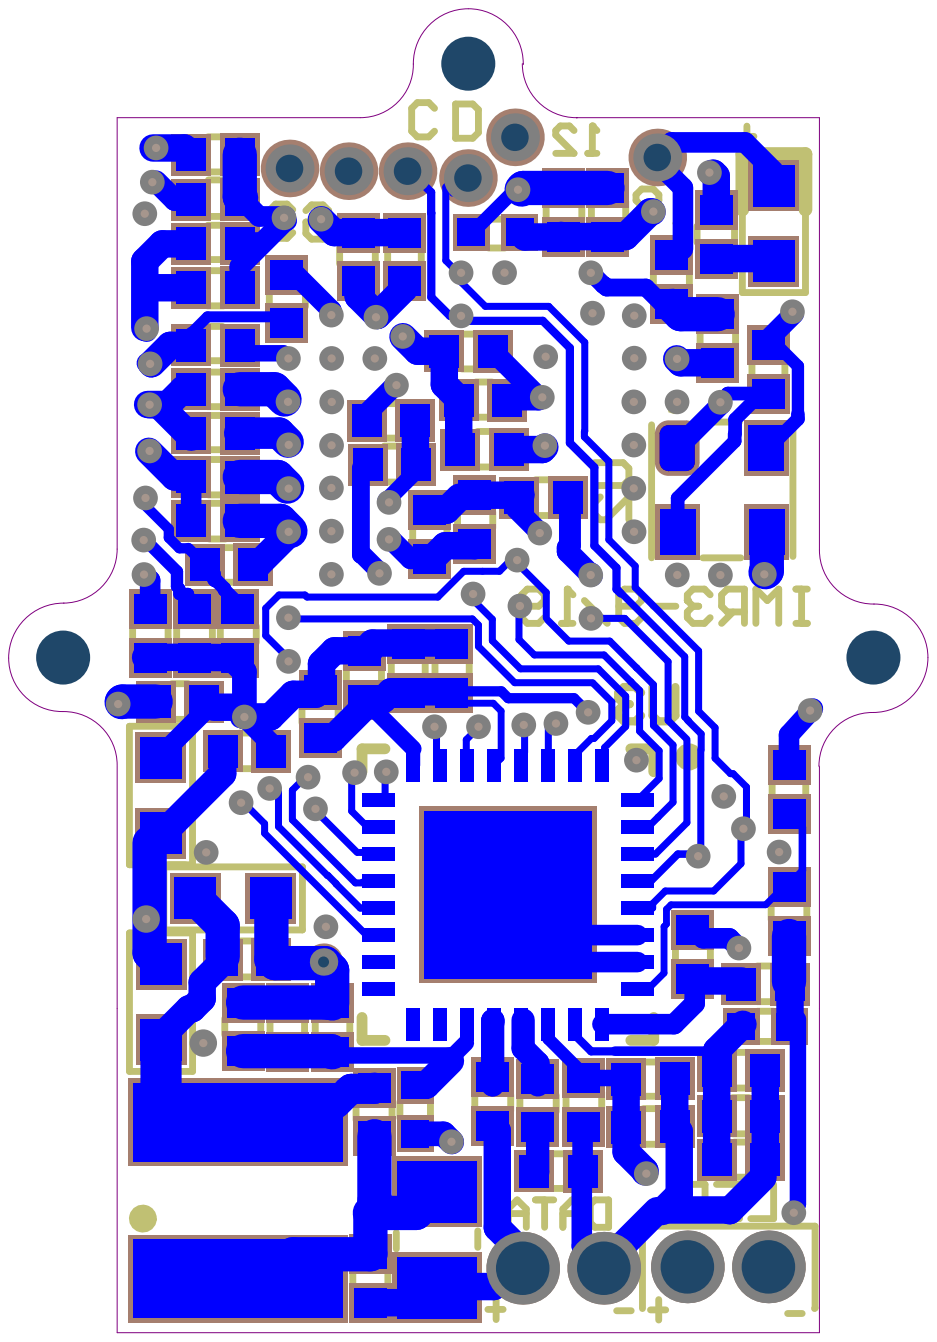
[picture p22: page 6]
