jjuneau1/MiniFAST/(list of files, drawings)

Other design files:
MiniFAST PCB/Image_SensorR3.SchDoc
MiniFAST PCB/LED_DriverR3.SchDoc
MiniFAST PCB/MiniPCBR3.PcbDoc
MiniFAST PCB/MiniR3.PrjPcb
MiniFAST PCB/PowerR3.SchDoc
