jjuneau1/MiniFAST/Miniscope MiniFAST GUI/resource.h

//{{NO_DEPENDENCIES}}
// Microsoft Visual C++ generated include file.
// Used by MiniScopeControl.rc
//
#define IDM_ABOUTBOX                    0x0010
#define IDD_ABOUTBOX                    100
#define IDS_ABOUTBOX                    101
#define IDD_MINISCOPECONTROL_DIALOG     102
#define IDR_MAINFRAME                   128
#define IDD_CAMDISCONNECTED             129
#define IDC_SLIDEREXCITATION            1000
#define IDC_SLIDEROPTO                  1001
#define IDC_POWEREXCITATION             1002
#define IDC_SLIDEROPTO2                 1002
#define IDC_POWEROPTO                   1003
#define IDC_DISCONNECT                  1004
#define IDC_CONNECT                     1005
#define IDC_EDIT1                       1006
#define IDC_MINFLUOR                    1006
#define IDC_EDIT2                       1007
#define IDC_EDIT3                       1008
#define IDC_TRIGGERIN                   1009
#define IDC_MAXFLUOR                    1009
#define IDC_TRIGGEROUT                  1010
#define IDC_MINFLUORDISPLAY             1010
#define IDC_TIMESTAMP                   1011
#define IDC_MAXFLUORDISPLAY             1011
#define IDC_LOAD                        1012
#define IDC_SAVE                        1013
#define IDC_LEDCONTROL                  1014
#define IDC_I0                          1016
#define IDC_I1                          1017
#define IDC_I2                          1018
#define IDC_I3                          1019
#define IDC_I4                          1020
#define IDC_I5                          1021
#define IDC_I6                          1022
#define IDC_I7                          1023
#define IDC_O0                          1024
#define IDC_O1                          1025
#define IDC_O2                          1026
#define IDC_O3                          1027
#define IDC_O4                          1028
#define IDC_O5                          1029
#define IDC_O6                          1030
#define IDC_O7                          1031
#define IDC_LIST1                       1032
#define IDC_EDIT4                       1035
#define IDC_EDIT5                       1036
#define IDC_SCOPECONNECT                1037
#define IDC_BEHAVIORCONNECT             1038
#define IDC_RECORD                      1039
#define IDC_STOPRECORD                  1040
#define IDC_EDIT6                       1041
#define IDC_SLIDERSCOPEEXPOSURE         1042
#define IDC_EDIT7                       1043
#define IDC_EDIT8                       1044
#define IDC_EDIT9                       1045
#define IDC_EDIT10                      1046
#define IDC_EDIT11                      1047
#define IDC_EDIT12                      1048
#define IDC_EDIT13                      1049
#define IDC_EDIT14                      1050
#define IDC_EDIT15                      1051
#define IDC_SUBMITNOTE                  1052
#define IDC_RESETROI                    1053
#define IDC_EDIT16                      1054
#define IDC_CHECK1                      1055
#define IDC_SLIDERSCOPEGAIN             1056
#define IDC_EDIT17                      1057
#define IDC_CHECK2                      1058
#define IDC_EDIT18                      1059
#define IDC_RED                         1060
#define IDC_GREEN                       1061
#define IDC_SLIDERBEHAVEXPOSURE         1062
#define IDC_EDIT19                      1063
#define IDC_BEHAVPROP                   1064
#define IDC_SCREENSHOT                  1065
#define IDC_CHECKTRIGREC                1066
#define IDC_EDIT20                      1067
#define IDC_SCOPECONNECT2               1068
#define IDC_CHECK3                      1068
#define IDC_COMBO1                      1069
#define IDC_COMBO2                      1070

// Next default values for new objects
// 
#ifdef APSTUDIO_INVOKED
#ifndef APSTUDIO_READONLY_SYMBOLS
#define _APS_NEXT_RESOURCE_VALUE        131
#define _APS_NEXT_COMMAND_VALUE         32771
#define _APS_NEXT_CONTROL_VALUE         1070
#define _APS_NEXT_SYMED_VALUE           101
#endif
#endif
